dbadb/dbStompbox/(commit log)

2022-04-14 Mention the soldering iron.
2022-04-17 trs wiring
